danvolchek/door-unlocker/Door.FCStd

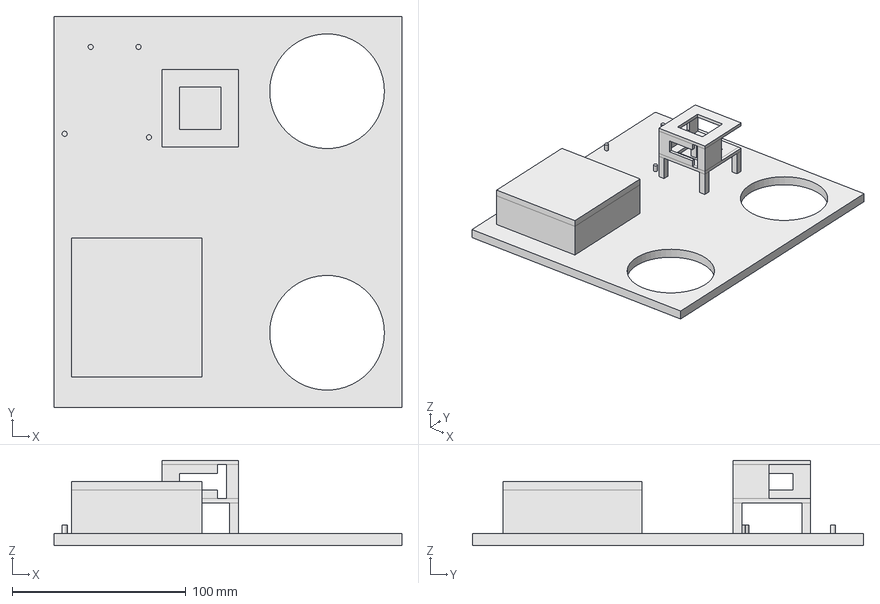
[picture p3: CAD file, 2019-05-01]
Door.FCStd
200.0 x 225.0 x 49.2 mm
