danvolchek/door-unlocker/(commit log)

2019-05-01 add wiring diagram
2019-05-01 update wiring diagram
